qu1j0t3/gpib-adapter/fft/badsine-horn2.png

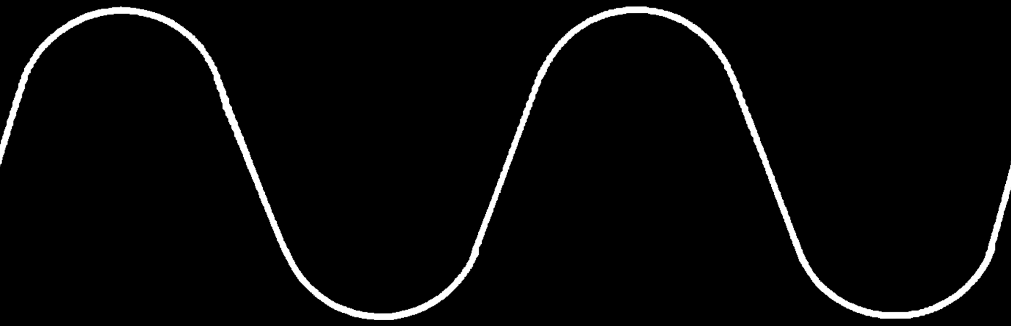
fft/badsine-horn2.png
