qu1j0t3/gpib-adapter/protoboard.png

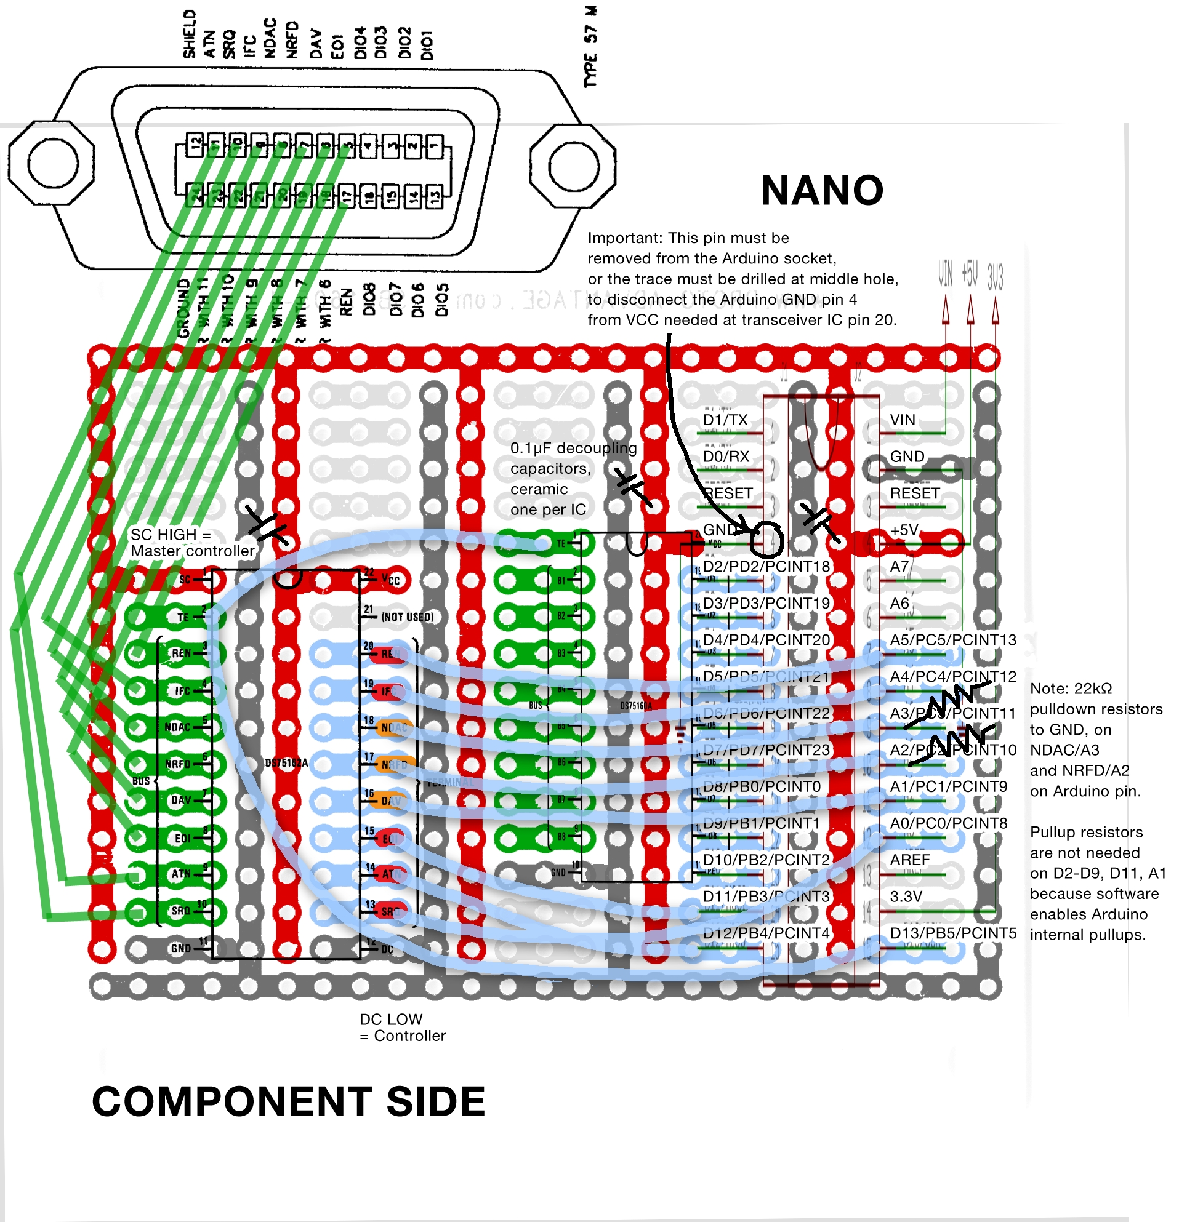
protoboard.png
