qu1j0t3/gpib-adapter/sine.bmp

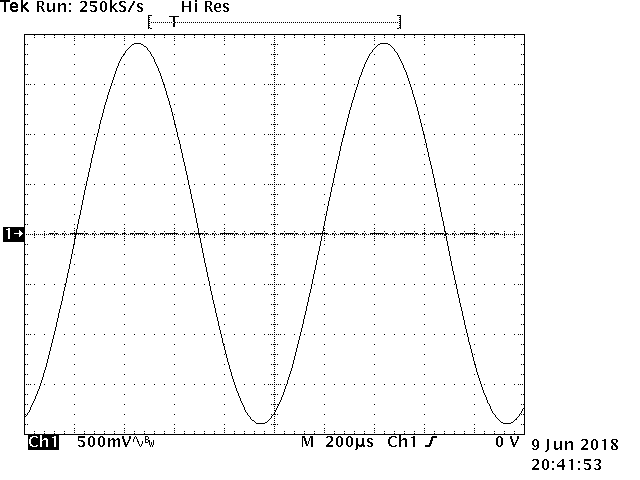
sine.bmp
