qu1j0t3/gpib-adapter/sine_fullcycle.png

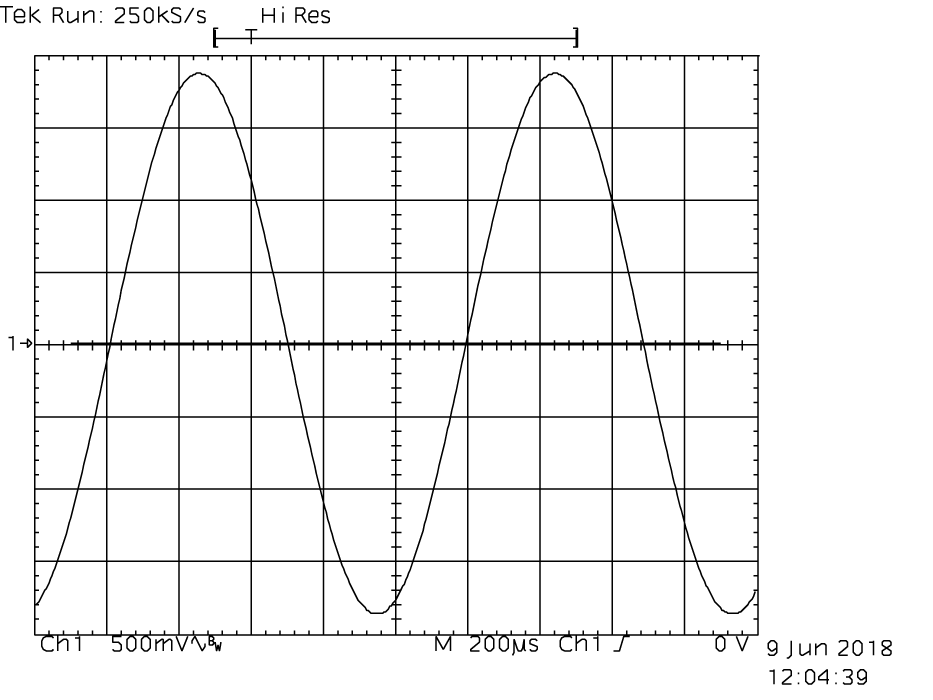
sine_fullcycle.png
