qu1j0t3/gpib-adapter/(commit log)

2018-06-04 Fix mixup of input/output port registers.
    [controller.ino]
2018-06-09 Fix return value of send_query. Add 500 point sine wave example.
    [controller.ino]
2018-06-09 Update with resistors.
2018-06-10 Fix base64 formatting bug.
    [controller.ino]
2018-06-10 Increase receive timeout for slow devices.
2018-06-17 Add help text. Shorten strings to save space.
    [controller.ino]
2018-06-17 Began watchdog reset, but not working yet.
    [controller.ino]
2018-06-18 Simple Python DFT for computing total harmonic distortion from sampled curve data.
2018-06-24 Add note about removing pin.
